ik1apw/Morse-code-oscillophone/foto/foto1.jpeg

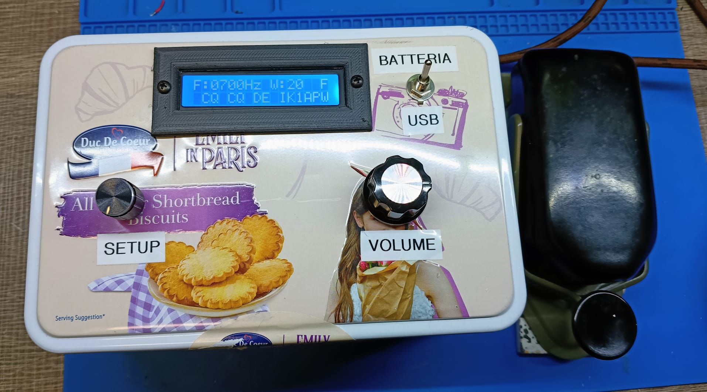
foto/foto1.jpeg
