ik1apw/Morse-code-oscillophone/foto/Foto_interno_v2.jpeg

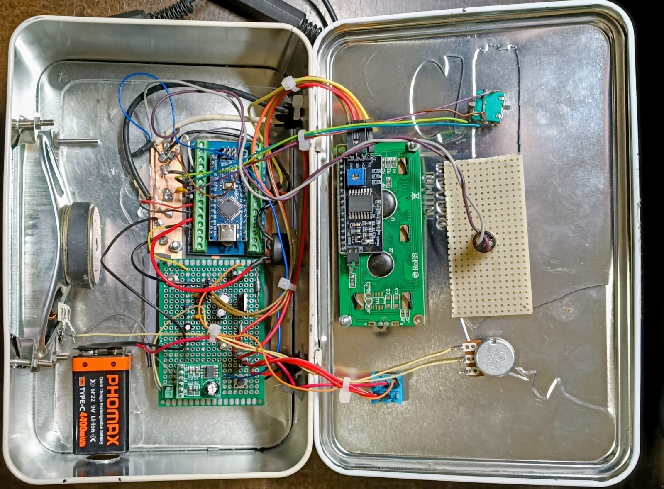
foto/Foto_interno_v2.jpeg
