ik1apw/Morse-code-oscillophone/documentation/Quick_Reference_Oscillofono_v1.0_Didattico.pdf

# Oscillofono Didattico CW

Quick Reference per Corsisti by IK1APW – Emanuele Rossi

### Comandi Encoder

Rotazione
Modalità F: varia la frequenza CW (±10 Hz per scatto) Modalità W: varia la velocità CW (±1 WPM per scatto) Pulsante Encoder
Pressione breve (< 2 s): cambia modalità (F ↔ W) Pressione lunga (> 2 s): cancella il testo decodificato

### Tasto Telegrafico

Premere il tasto per generare la nota CW.
Il testo Morse viene automaticamente decodificato e visualizzato.

### Display

Riga 1: Frequenza CW, Velocità WPM, Modalità attiva (F/W) Riga 2: Testo Morse decodificato

### Valori consigliati per esercitazione

Frequenza: 600 – 800 Hz
Velocità: 15 – 18 WPM

Documento rapido di supporto per corsi di telegrafia CW. Uso didattico – riproduzione consentita.
