ik1apw/Morse-code-oscillophone/documentation/Schema_Oscillofono_v1.0.pdf

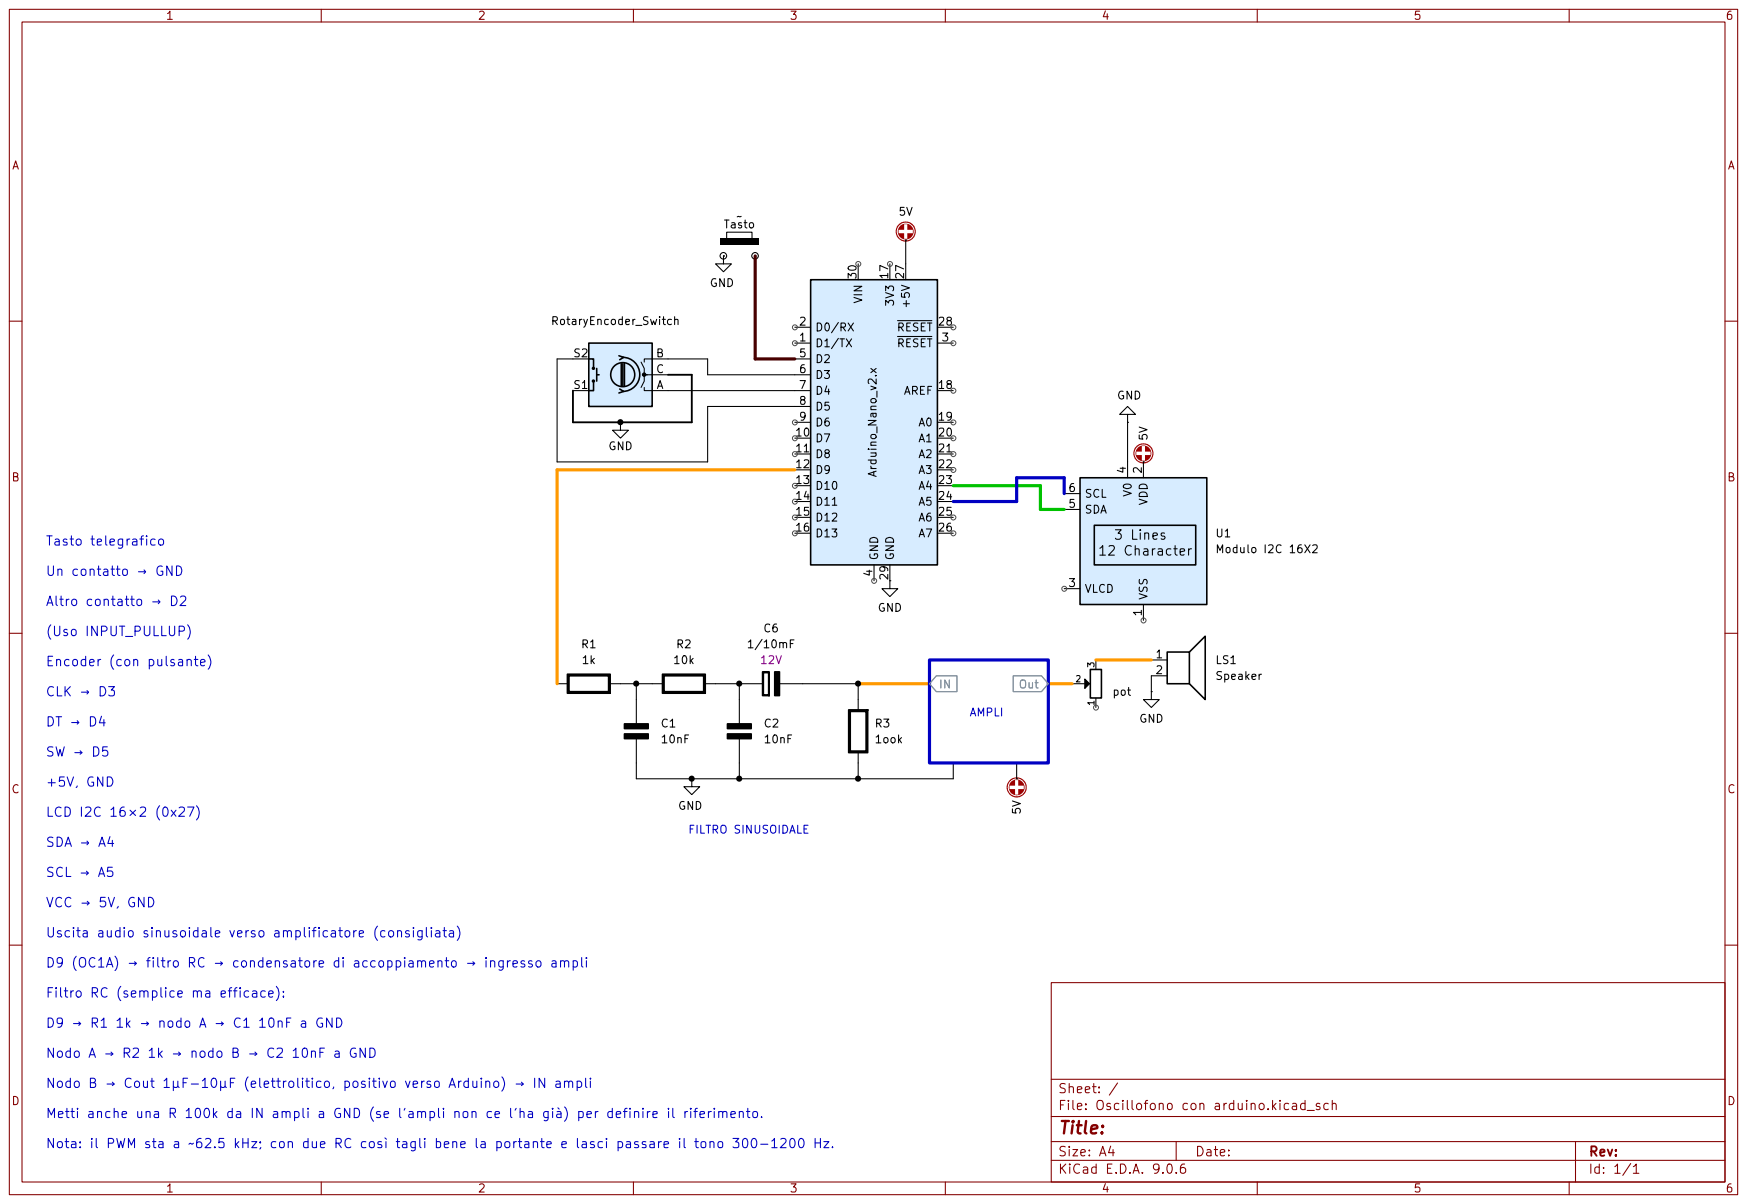
[picture p3: page 1]
